chaostreff-flensburg/ruetueta-loet-badge/(commit log)

2022-01-12 add kicad and source files
    [ruetueta-pcb.kicad_pcb, ruetueta-pcb.kicad_sch]
2022-01-27 first routed layout
    [ruetueta-pcb.kicad_pcb, ruetueta-pcb.kicad_sch]
2022-02-03 add production files
    [ruetueta-pcb-B_Cu.gbr, ruetueta-pcb-B_Mask.gbr, ruetueta-pcb-B_Paste.gbr, ruetueta-pcb-B_Silkscreen.gbr, ruetueta-pcb-Edge_Cuts.gbr, ruetueta-pcb-F_Cu.gbr, ruetueta-pcb-F_Mask.gbr, ruetueta-pcb-F_Paste.gbr]
2022-02-19 add logo copper fill zone; rearrange and reroute tracks
    [ruetueta-pcb.kicad_pcb]
2022-03-11 changed footprint for and placement of transistors; moved most components and vias away from ruetueta logo
    [ruetueta-pcb.kicad_pcb, ruetueta-pcb.kicad_sch]
2022-03-14 update routes; clean things up
    [ruetueta-pcb.kicad_pcb]
2022-03-15 update footprints for bigger solder pads
    [ruetueta-pcb.kicad_pcb]
2022-03-15 add production files 2-1
    [ruetueta-pcb-B_Cu.gbr, ruetueta-pcb-B_Mask.gbr, ruetueta-pcb-B_Paste.gbr, ruetueta-pcb-B_Silkscreen.gbr, ruetueta-pcb-Edge_Cuts.gbr, ruetueta-pcb-F_Cu.gbr, ruetueta-pcb-F_Mask.gbr, ruetueta-pcb-F_Paste.gbr]
